daddasd/19SmartCar/README.md

#六边环岛思路
##以左侧环岛为例
###左边侧边横向电感连续判断，电感值是否逐步递增，当左边电感逐步递增时，右边电感基本保持不变，且左侧竖直电感竖直突增，进入预判断圆环，编码器积分一段距离（此距离为预进圆环标志位，到圆环进入位）当左侧横向电感减小到，进入圆环的位置时，手动将误差清零，小车角度环，打死进入圆环，环内正常循迹，当小车右侧横向电感逐渐增大时，判断为预出圆环，编码器积分一段距离，手动将误差清零，小车角度环，打死出圆环，将圆环元素标志清除，防止误判断。
