daddasd/19SmartCar/Camellia2/Version_Updating.txt

Car :  V1.0 可以读取电感值  2023/9/6
Car :  V2.0 增加 舵机PID调节 ，与开环电机 （电机齿轮有问题），基本能拐弯(开环写死) 2023/9/14
Car :  V2.5 可以编码器调速，实现闭环控制 ，pid速度环，并放置是输出限制，
Car ： V4.0 重大突破，完成基础循迹（扫描赛道程序完成，舵机通过PD位置环控制，能更快的响应，且能让舵机打角更加丝滑，注意（P建议调小，D的值要非常大，才能对弯道的拟合程度更好，需要不断调试）未来将通过主动差速与改变舵机频率来使弯道响应更快，以及上陀螺仪）23/10/17
Car :  速度已经上到1.6m/s 可以上串级PID来使在转弯到巡线的过程中更加稳定
                    /|
                   / |
                  /  |
                 /   |
                /    |

Car :  赛题下来，4轮寄，换成三轮，全新挑战
Car :  采用串级方向环，并级速度环，速度环加减方向环一起输出给电机，感谢Ca佬提出的方法，并换成主控stc32f12k系列
Car :  元旦前定下代码的整体结构与算法        2023/11/17

Car : 完成串级PID与并级PID，小车以可以巡线，之前的算法以纠正，争取明天铺好赛道，月底先以1.8m/s完赛，6月末争取将速度提到2.7m/s,,路上采的坑很多，路漫漫其修远兮，。希望下一届能吸取我们的教训，调出更好的成绩。 2024/5/9
