daddasd/19SmartCar/(list of files, cad)

Other CAD files:
Camellia2/Camellia/MDK/Out_File/main.obj
Camellia2/Camellia/MDK/Out_File/SEEKFREE_IPS114_SPI.obj
Camellia2/Camellia/MDK/Out_File/Inductance.obj
Camellia2/Camellia/MDK/Out_File/zf_delay.obj
Camellia2/Camellia/MDK/Out_File/board.obj
Camellia2/Camellia/MDK/Out_File/SEEKFREE_BLUETOOTH_CH9141.obj
Camellia2/Camellia/MDK/Out_File/SEEKFREE_TSL1401.obj
Camellia2/Camellia/MDK/Out_File/zf_nvic.obj
Camellia2/Camellia/MDK/Out_File/Motor.obj
Camellia2/Camellia/MDK/Out_File/isr.obj
Camellia2/Camellia/MDK/Out_File/zf_tim.obj
Camellia2/Camellia/MDK/Out_File/RGB.obj
Camellia2/Camellia/MDK/Out_File/zf_pwm.obj
Camellia2/Camellia/MDK/Out_File/zf_gpio.obj
Camellia2/Camellia/MDK/Out_File/SEEKFREE_ICM20602.obj
Camellia2/Camellia/MDK/Out_File/SEEKFREE_WIRELESS.obj
Camellia2/Camellia/MDK/Out_File/SEEKFREE_DL1A.obj
Camellia2/Camellia/MDK/Out_File/SEEKFREE_MPU6050.obj
Camellia2/Camellia/MDK/Out_File/vofa.obj
Camellia2/Camellia/MDK/Out_File/SEEKFREE_ABSOLUTE_ENCODER.obj
Camellia2/Camellia/MDK/Out_File/SEEKFREE_FONT.obj
Camellia2/Camellia/MDK/Out_File/SEEKFREE_18TFT.obj
Camellia2/Camellia/MDK/Out_File/zf_spi.obj
Camellia2/Camellia/MDK/Out_File/TrackElement.obj
Camellia2/Camellia/MDK/Out_File/zf_eeprom.obj
Camellia2/Camellia/MDK/Out_File/ALLInit.obj
Camellia2/Camellia/MDK/Out_File/zf_exti.obj
Camellia2/Camellia/MDK/Out_File/zf_iic.obj
Camellia2/Camellia/MDK/Out_File/common.obj
Camellia2/Camellia/MDK/Out_File/SEEKFREE_VIRSCO.obj
Camellia2/Camellia/MDK/Out_File/encoder.obj
Camellia2/Camellia/MDK/Out_File/SEEKFREE_IMU963RA.obj
Camellia2/Camellia/MDK/Out_File/SEEKFREE_PRINTF.obj
Camellia2/Camellia/MDK/Out_File/SEEKFREE_IMU660RA.obj
Camellia2/Camellia/MDK/Out_File/direction.obj
Camellia2/Camellia/MDK/Out_File/zf_adc.obj
Camellia2/Camellia/MDK/Out_File/menu.obj
Camellia2/Camellia/MDK/Out_File/zf_uart.obj
Camellia2/Camellia/MDK/Out_File/SEEKFREE_OLED.obj
Camellia2/Camellia/MDK/Out_File/zf_fifo.obj
Camellia2/Camellia/MDK/Out_File/mpu6050.obj
