daddasd/19SmartCar/Camellia2/Camellia/USER/Hardware/encoder.c

#include "myconfig.h"

int dir_out = 0, nh_out = 0;
int L_Pulse = 0, R_Pulse = 0, Sum_Pulse = 0;
double angle1 = 0.0;
int speed = 105;
float Ang = 0;


float L = 0, R = 0;
//--
//  @brief    	???????????
//  @param      void
//  @return     void
//--

void Encoder_Time_Init(void)
{
	pit_timer_ms(TIM_4, 2);
	gpio_mode(Encoder_L, GPI_IMPEDANCE);
	gpio_mode(Encoder_R, GPI_IMPEDANCE);
	ctimer_count_init(Encoder_L);
	ctimer_count_init(Encoder_R);
	EnableGlobalIRQ();
}

//--
//  @brief    	??????????????
//  @param      void
//  @return     return : ?????
//--

int L_Encoder_Pulse(void)
{
	if (DIL == 0)
	{
		L_Pulse =-ctimer_count_read(Encoder_L);
	}
	else
	{
		L_Pulse =ctimer_count_read(Encoder_L);
	}
	ctimer_count_clean(Encoder_L);
	return L_Pulse;
}

//--
//  @brief    	??????????????
//  @param      void
//  @return     return : ?????
//--
int R_Encoder_Pulse(void)
{
	if (DIR == 0)
	{
		R_Pulse = ctimer_count_read(Encoder_R);
	}
	else
	{
		R_Pulse =-ctimer_count_read(Encoder_R);
	}
	ctimer_count_clean(Encoder_R);
	return R_Pulse;
}

//--
//  @brief    	?????????
//  @param      void
//  @return     void
//--
void Encoder_Read_Pulse(void)
{
	L_Encoder_Pulse();
	R_Encoder_Pulse();
}
//--
//  @brief    	???????????
//  @param      L_cont??R_cont?????????
//  @return     void
//--
int L_Enc_integral(int L_target)
{
	static int L = 0, L_flag;
	L += L_Encoder_Pulse();
	if (L > L_target)
	{
		L_flag = 1;
	}
	if (L_flag == 1)
	{
		L = 0;
		L_flag = 0;
		return 0;
	}
	return 1;
}

int R_Enc_integral(int R_target)
{
	static int R = 0, R_flag;
	R += R_Encoder_Pulse();
	if (R > R_target)
	{
		R_flag = 1;
	}
	if (R_flag == 1)
	{
		R_flag = 0;
		R = 0;
		return 0;
	}
	return 1;
}

void TM4_Isr() interrupt 20
{
	static int count = 0, OUT1, OUT2, groy = 0;
	int nh = 0;
	if (Car_Start_Flag)
	{
		mpu6050_get_gyro();
		L_Pulse = L_Encoder_Pulse()*0.7;
		R_Pulse = R_Encoder_Pulse()*0.7;
		NORMALIZATION_TRACKING_ADC(1,1);
		// Roundabout();
		// if(Track_flag)
		// Right_Angle();
		// Error_Speed();
		// if(Angle_Ring(90, 25, 1))
		// 	{
				
		// 	}
		//Car_Distance(2024);
		//Angle_Ring1(90, 180, 1080);

		//Angle_Ring1(90, 0.7,3);	
		//		L = L_Pulse;
		//		R = R_Pulse;
		//		OUT1 = LSpeed_pid_Out(30, L_Pulse);
		//		OUT2 = RSpeed_pid_Out(30, R_Pulse);
		// Motor_PWM(nh_out, -nh_out);

		//OUT2 = Speed_pid_Out(15, (L_Pulse+R_Pulse)*0.5);
		//OUT1=nh_Turn_Out(-10, Nh_P, Nh_D);
		//Motor_PWM(OUT1,-OUT1);
		//dir_out=DirControl();

		Tracking(20);
		TIM4_CLEAR_FLAG;
	}
}
