daddasd/19SmartCar/Camellia2/Camellia/USER/Hardware/menu.h

#ifndef __MENU_H_
#define __MENU_H_

#define key1 P20
#define key2 P21 
#define key3 P43 
#define key4 P37

extern float out_dir_p;
extern float out_dir_d;
extern float Mot_P;
extern float Mot_D;


int  Show_AllVal(int flag1);
int First_menu(void);
int Second_Element_menu(void);
int Second__NWHuan_menu(void);
int Second__Speed_menu(void);
int Show_Val_Menu(void);
int CarStart_Menu(void);
#endif
