daddasd/19SmartCar/Camellia2/Camellia/USER/Hardware/mpu6050.h

#ifndef _MPU6050_H
#define _MPU6050_H

extern int16  Angle;//陀螺仪角度
float gyro_zero_wander(void);
double Gyro_filter(double val);
double lowPassFilter(double current, double previous, float alpha);
double Get_Angle();

#endif
 
