daddasd/19SmartCar/Camellia2/Camellia/USER/Hardware/myconfig.h

#ifndef __MYCONFIG_H_
#define __MYCONFIG_H_
/*** 
 * @Description: 
 * @Author: Yzhi
 * @Date: 2023-11-17 20:12:24
 * @LastEditTime: 2023-11-17 21:32:25
 * @LastEditors: Yzhi
 */
#include "headfile.h"
#include "Inductance.h"
#include "Motor.h"
#include "encoder.h"
#include "direction.h"
#include "vofa.h"
#include "mpu6050.h"
#include "math.h"
#include "TrackElement.h"
#include "menu.h"
#include "RGB.h"
#include "ALLInit.h"

extern int Car_Start_Flag;
extern int Car_Stop_Flag;
extern float Gyro_Diff;

#endif
