daddasd/19SmartCar/(commit log)

2024-03-24 第19届北华风磁
    [Inductance.obj, Motor.obj, SEEKFREE_18TFT.obj, SEEKFREE_ABSOLUTE_ENCODER.obj, SEEKFREE_BLUETOOTH_CH9141.obj, SEEKFREE_DL1A.obj, SEEKFREE_FONT.obj, SEEKFREE_ICM20602.obj]
2024-03-24 again test
    [Inductance.obj, Motor.obj, SEEKFREE_18TFT.obj, SEEKFREE_ABSOLUTE_ENCODER.obj, SEEKFREE_BLUETOOTH_CH9141.obj, SEEKFREE_DL1A.obj, SEEKFREE_FONT.obj, SEEKFREE_ICM20602.obj]
2024-03-24 19届北华风磁力
    [Inductance.obj, Motor.obj, SEEKFREE_18TFT.obj, SEEKFREE_ABSOLUTE_ENCODER.obj, SEEKFREE_BLUETOOTH_CH9141.obj, SEEKFREE_DL1A.obj, SEEKFREE_FONT.obj, SEEKFREE_ICM20602.obj]
2024-03-24 北华风磁
2024-03-24 菜单已经没有问题
2024-03-24 菜单写完
2024-04-10 已经能基础循迹v2.0
    [Inductance.obj, Motor.obj, SEEKFREE_18TFT.obj, SEEKFREE_ABSOLUTE_ENCODER.obj, SEEKFREE_BLUETOOTH_CH9141.obj, SEEKFREE_DL1A.obj, SEEKFREE_FONT.obj, SEEKFREE_ICM20602.obj]
2024-04-11 可以循迹
    [Inductance.obj, Motor.obj, SEEKFREE_18TFT.obj, SEEKFREE_ABSOLUTE_ENCODER.obj, SEEKFREE_BLUETOOTH_CH9141.obj, SEEKFREE_DL1A.obj, SEEKFREE_FONT.obj, SEEKFREE_ICM20602.obj]
2024-04-12 编码器滤波
    [Inductance.obj, Motor.obj, SEEKFREE_18TFT.obj, SEEKFREE_ABSOLUTE_ENCODER.obj, SEEKFREE_BLUETOOTH_CH9141.obj, SEEKFREE_DL1A.obj, SEEKFREE_FONT.obj, SEEKFREE_ICM20602.obj]
2024-04-13 左电感大于右电感
2024-04-15 1.5m 4/13
    [Inductance.obj, Motor.obj, SEEKFREE_18TFT.obj, SEEKFREE_ABSOLUTE_ENCODER.obj, SEEKFREE_BLUETOOTH_CH9141.obj, SEEKFREE_DL1A.obj, SEEKFREE_FONT.obj, SEEKFREE_ICM20602.obj]
2024-05-03 重构文件夹
    [Inductance.obj, Motor.obj, SEEKFREE_18TFT.obj, SEEKFREE_ABSOLUTE_ENCODER.obj, SEEKFREE_BLUETOOTH_CH9141.obj, SEEKFREE_DL1A.obj, SEEKFREE_FONT.obj, SEEKFREE_ICM20602.obj]
2024-05-03 测试git合并
2024-05-04 增加RGB功能
    [ALLInit.obj, Inductance.obj, Motor.obj, RGB.obj, SEEKFREE_18TFT.obj, SEEKFREE_ABSOLUTE_ENCODER.obj, SEEKFREE_BLUETOOTH_CH9141.obj, SEEKFREE_DL1A.obj]
2024-05-04 正在重新更改代码结构
    [ALLInit.obj, Inductance.obj, Motor.obj, RGB.obj, SEEKFREE_18TFT.obj, SEEKFREE_ABSOLUTE_ENCODER.obj, SEEKFREE_BLUETOOTH_CH9141.obj, SEEKFREE_DL1A.obj]
2024-05-05 菜单Bug已修
    [ALLInit.obj, Inductance.obj, Motor.obj, RGB.obj, SEEKFREE_18TFT.obj, SEEKFREE_ABSOLUTE_ENCODER.obj, SEEKFREE_BLUETOOTH_CH9141.obj, SEEKFREE_DL1A.obj]
2024-05-05 将内环改为增量式，把电机I输出的限幅去掉
    [ALLInit.obj, Inductance.obj, Motor.obj, RGB.obj, SEEKFREE_18TFT.obj, SEEKFREE_ABSOLUTE_ENCODER.obj, SEEKFREE_BLUETOOTH_CH9141.obj, SEEKFREE_DL1A.obj]
2024-05-06 角速度环
    [ALLInit.obj, Inductance.obj, Motor.obj, RGB.obj, TrackElement.obj, direction.obj, encoder.obj, main.obj]
2024-05-06 角速度环增量式
    [ALLInit.obj, Inductance.obj, Motor.obj, RGB.obj, TrackElement.obj, direction.obj, encoder.obj, main.obj]
2024-05-07 角速度环参数整定
    [ALLInit.obj, Inductance.obj, Motor.obj, RGB.obj, TrackElement.obj, direction.obj, encoder.obj, main.obj]
2024-05-07 调参ok
    [ALLInit.obj, Inductance.obj, Motor.obj, RGB.obj, TrackElement.obj, direction.obj, encoder.obj, main.obj]
2024-05-07 合并调参分支
2024-05-07 First submission of pin allocation 第一次提交引脚分配
2024-05-08 主驱一体Vn更新预告！
2024-05-08 速度环参数整定完成
    [ALLInit.obj, Inductance.obj, Motor.obj, RGB.obj, TrackElement.obj, direction.obj, encoder.obj, main.obj]
2024-05-08 引脚修改完毕
    [ALLInit.obj, Inductance.obj, Motor.obj, RGB.obj, SEEKFREE_MPU6050.obj, SEEKFREE_OLED.obj, TrackElement.obj, direction.obj]
2024-05-09 引脚测试完成
    [ALLInit.obj, Inductance.obj, Motor.obj, RGB.obj, TrackElement.obj, direction.obj, encoder.obj, main.obj]
2024-05-09 元素思路
2024-05-11 角度环参数整定完成
    [ALLInit.obj, Inductance.obj, Motor.obj, RGB.obj, SEEKFREE_MPU6050.obj, SEEKFREE_OLED.obj, TrackElement.obj, direction.obj]
2024-05-12 角度环参数再次整定
    [ALLInit.obj, Inductance.obj, Motor.obj, RGB.obj, SEEKFREE_18TFT.obj, SEEKFREE_ABSOLUTE_ENCODER.obj, SEEKFREE_BLUETOOTH_CH9141.obj, SEEKFREE_DL1A.obj]
2024-05-13 角度环与角速度环参数再次整定完毕
    [ALLInit.obj, Inductance.obj, Motor.obj, RGB.obj, SEEKFREE_18TFT.obj, SEEKFREE_ABSOLUTE_ENCODER.obj, SEEKFREE_BLUETOOTH_CH9141.obj, SEEKFREE_DL1A.obj]
2024-05-16 2024年5月16日 引脚更新说明
