daddasd/19SmartCar/(notices)

Notices in the files:
Camellia2/Camellia/USER/src/isr.c:
* Copyright (c) 2020,Öð·É¿Æ¼¼
* All rights reserved.
